CrackpotGumption/mole_code/instructable/project/drawings/06_controller_schematic.png

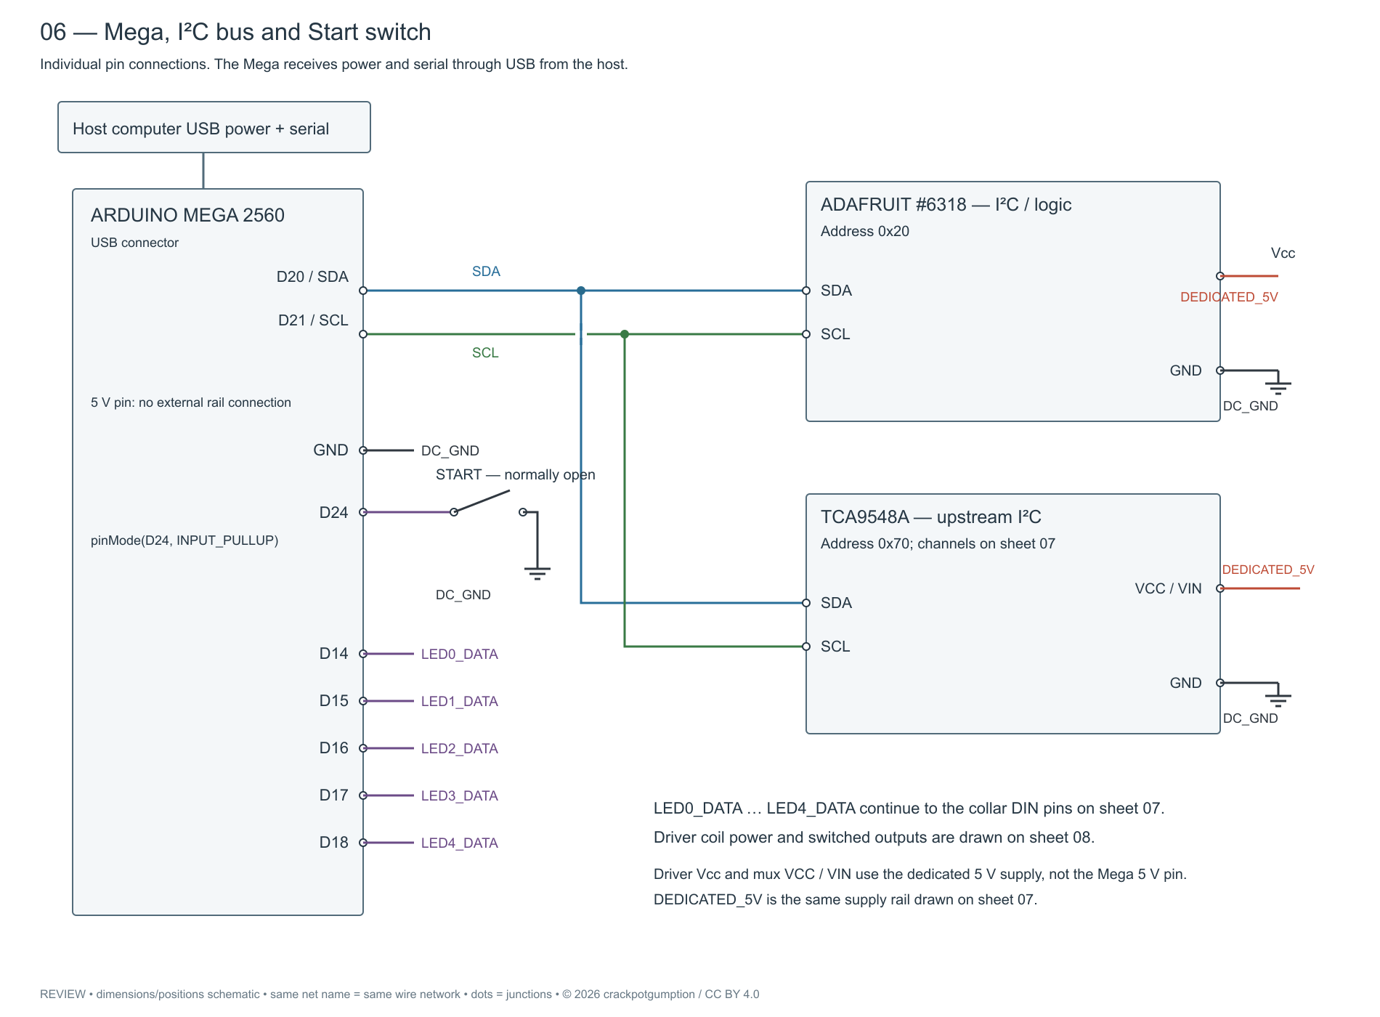
instructable/project/drawings/06_controller_schematic.png
