CrackpotGumption/mole_code/portal/audio-preview.jpg

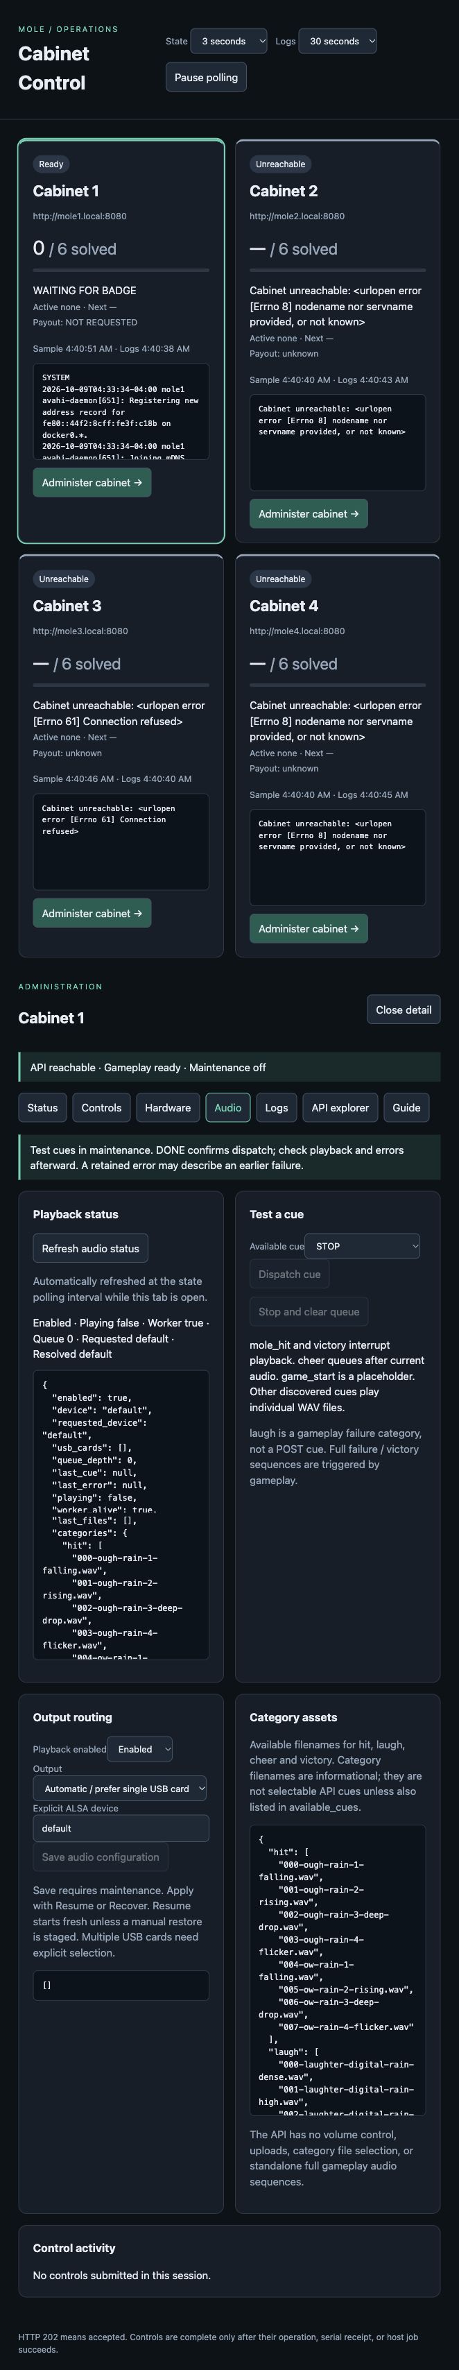
portal/audio-preview.jpg
