CrackpotGumption/mole_code/portal/preview.jpg

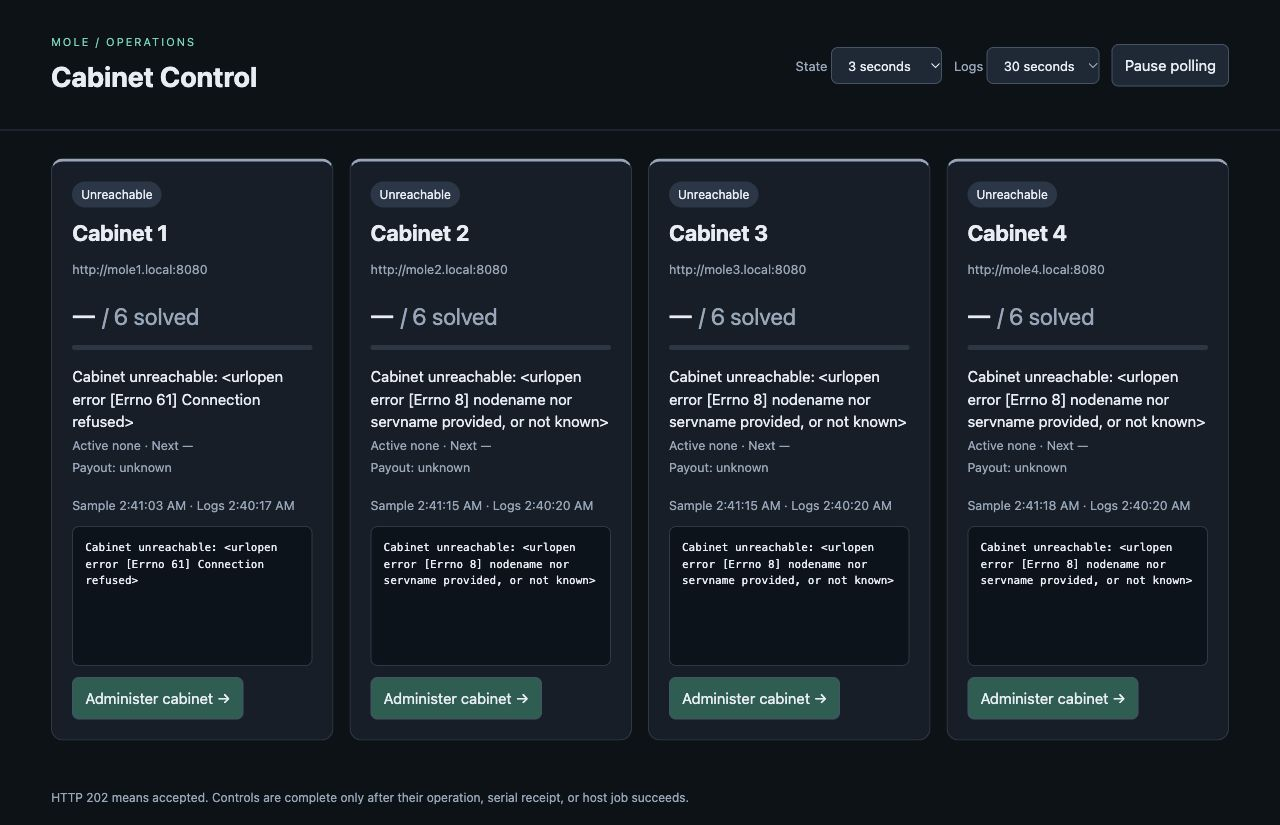
portal/preview.jpg
