CrackpotGumption/mole_code/instructable/project/BOM.md

# Supplies — one cabinet

*Amazon links are affiliate links. As an Amazon Associate I earn from qualifying purchases.*

Quantities below describe one cabinet. Pack sizes and spool/tube lengths describe the linked purchase, not the amount required. Prices are omitted.

## Cabinet

- [Scotch black Extreme Fasteners RF6741, 1-inch × 4-foot, two rolls](https://www.homedepot.com/p/Scotch-1-in-x-4-ft-Black-Extreme-Fasteners-2-Rolls-RF6741/205520125), as needed for removable fastening. This was the removable fastener used in the build. Refer to it as interlocking removable fasteners rather than assuming a textile hook-and-loop construction.

- [Grip-Rite #8 × 2-inch construction screws, 2GCS1](https://www.homedepot.com/p/Grip-Rite-8-x-2-in-Star-Drive-Dual-Flat-Head-Coarse-Thread-Construction-Screws-1-lb-Box-2GCS1/204959257): 2×2-to-plywood connections; also caster fasteners where they enter the inner 2×2 rail.
- Four [3-inch rubber swivel casters with brakes, Harbor Freight item 61855](https://www.harborfreight.com/3-in-rubber-light-duty-swivel-caster-with-brake-61855.html). Mount about 1 inch in from the corners, catching the inner 2×2 framing on at least one side. Use 2-inch screws into the rail and ¾-inch screws on the other side.
- Screw-use clarification: 2½-inch screws were used for 2×2-to-2×2 connections; 2-inch screws for 2×2-to-plywood connections. Do not use the 2½-inch frame screws for the plywood connection pattern.

Confirmed ¾-inch plywood cuts: three 36 × 24-inch panels (two sides and top/playfield), one 36 × 23.25-inch bottom, one 36 × 35.25-inch front, and two 19.2 × 35.75-inch deck panels. The bottom's ¾-inch front setback allows the front panel to drop down and align with the sides. See PLYWOOD_CUT_LIST.md; sheet nesting and hole details remain to be drawn.

- Five [Oatey Fast Set flanges, model 435032, 3-inch outside fit / 4-inch inside fit](https://www.homedepot.com/p/Oatey-Fast-Set-3-in-Outside-Fit-or-4-in-Inside-Fit-PVC-Open-Hub-Toilet-Flange-435032/100344482).
- [Charlotte Pipe 3-inch Schedule 40 PVC, 2-foot purchase length](https://www.homedepot.com/p/Charlotte-Pipe-3-in-x-2-ft-PVC-DWV-Sch-40-Pipe-PVC073000200HA/100533056). Cut five 2-inch sleeves. About one foot including cutting waste is sufficient; buy a shorter length or request store cuts if available.
- [Everbilt #8 × 1-inch flat-head wood screws, 100-pack](https://www.homedepot.com/p/Everbilt-8-x-1-in-Zinc-Plated-Phillips-Flat-Head-Wood-Screw-100-Pack-801822/204275495): mechanism and flange fastening; at least 40 for puck/base mounts plus flange screws and spares.
- [Everbilt #8 × ¾-inch flat-head wood screws, 100-pack](https://www.homedepot.com/p/Everbilt-8-x-3-4-in-Phillips-Flat-Head-Zinc-Plated-Wood-Screw-100-Pack-801812/204275494): shorter mounting fasteners; final placement/count to be documented.
- [Grip-Rite #8 × 2½-inch general-purpose wood screws](https://www.homedepot.com/p/Grip-Rite-8-x-2-1-2-in-2-Phillips-Bugle-Head-Coarse-Thread-Wood-Screws-1-lb-Box-212GS1/100128995): frame joints.
- [Kreg K4 pocket-hole jig](https://www.amazon.com/dp/B001DYFISG?tag=crackpotgum00-20): one tool.
- [LIONMAX #8 × 2½-inch pocket-hole screws](https://www.amazon.com/dp/B0C23LJ6LJ?tag=crackpotgum00-20): pocket-hole joints in the nominal 2×2 framing; linked pack contains 300 screws, not the required cabinet quantity.
- Pneumatic thread tape is supplied with the tubing/solenoid purchases. No separate tape purchase is needed for the documented build; use only on compatible threaded joints.

| Supply | Quantity | Use / remaining check |
|---|---|---|
| [ZANEXIR black felt sheet, 36 × 36 inches, 1 mm](https://www.amazon.com/dp/B0GV7ZK5MX?tag=crackpotgum00-20) | 1 sheet | Trim for the 36 × 34.5-inch rear cover. Confirm stiffness/suitability; listing is 1 mm, not heavy felt. |

## Pneumatics

| Supply | Quantity | Use / remaining check |
|---|---|---|
| [TAILONZ MAL16×75 double-acting cylinder, 16 mm bore × 75 mm stroke](https://www.amazon.com/dp/B08CZ39Y42?tag=crackpotgum00-20) | 5 | Includes fittings listed as 6 mm. The builder confirms these work with the linked ¼-inch tubing in the completed build. Rod/base thread sizes remain to be recorded. |
| [AIRIX 4V210-08 12 V five-way, two-position valve, ¼-inch NPT](https://www.amazon.com/dp/B0F2MQF6K7?tag=crackpotgum00-20) | 5 | Listing states 25–116 PSI and pilot operation. Confirm operation at the approximately 25 PSI setting under load; verify physical port markings. |
| [TAILONZ blue polyurethane air tubing, ¼-inch OD, 200 ft](https://www.amazon.com/dp/B09CPG48SL?tag=crackpotgum00-20) | As needed | Compressor/manifold/valve/cylinder runs; 200 ft is purchase length, not a one-cabinet requirement. |
| [TAILONZ straight push fittings, ¼-inch tube OD × ¼-inch MNPT, 20-pack](https://www.amazon.com/dp/B08F4YHR1V?tag=crackpotgum00-20) | Count after routing | For compatible ¼-inch NPT ports; not assumed to fit cylinder ports. |

## Power and electronics

| Supply | Quantity | Use / remaining check |
|---|---|---|
| [Amazon Basics six-outlet surge-protected power strip, 2-pack](https://www.amazon.com/dp/B0D1XNYKD5?tag=crackpotgum00-20) | 1 strip | Electronics only. Compressor has a separate external cord/outlet. |
| [12 V 5 A power adapter](https://www.amazon.com/dp/B07GFFG1BQ?tag=crackpotgum00-20) | 1 | Valve-coil supply; separate from 5 V supply. |
| [AITRIP TCA9548A eight-channel I²C multiplexer, 6-pack](https://www.amazon.com/dp/B08JGSMRF9?tag=crackpotgum00-20) | 1 board | Five sensors use channels 0–4; purchase pack contains spares. |
| [Mega 2560 screw-terminal breakout board](https://www.amazon.com/dp/B0BY8SHQZS?tag=crackpotgum00-20) | 1 | Controller wiring termination. Check fit against the actual Mega; listing has inconsistent board-compatibility text. |
| [ELEGOO Mega 2560 R3 board](https://www.amazon.com/dp/B01H4ZDYCE?tag=crackpotgum00-20) | 1 | Hardware controller, USB-powered by host. |

## Wiring

- [18 AWG feeder wire](https://www.amazon.com/dp/B07FMWNF3J?tag=crackpotgum00-20), as needed for the deck power feeders.
- The linked Fermerry 22 AWG wire is the builder's general-use wiring; keep the 18 AWG power feeders separate.

- [WAGO 221-412 two-conductor lever connectors](https://www.amazon.com/dp/B00JB3U7Y6?tag=crackpotgum00-20), as needed for harness connections.
- [Zip-tie mounts](https://www.amazon.com/dp/B09B8NY4SN?tag=crackpotgum00-20), as needed for cable routing and moving-wire management.

| Supply | Quantity | Use / remaining check |
|---|---|---|
| [Mini PCB screw-terminal connector assortment, 2.54 mm pitch](https://www.amazon.com/dp/B0FCXV6GT3?tag=crackpotgum00-20) | As needed | Sensor and low-voltage wiring connections; not the main power-distribution blocks. |
| [Amazon Basics multicolor electrical tape, 10-pack](https://www.amazon.com/dp/B07YDSNGCT?tag=crackpotgum00-20) | As needed | Wire labeling and insulation. |
| [Fermerry 22 AWG silicone stranded wire, six colors, 100 ft each](https://www.amazon.com/dp/B089D3LVYK?tag=crackpotgum00-20) | As needed | Low-current signal/sensor wiring and suitably sized pigtails; retain larger deck feeders sized for load. |

## Printed parts

| Supply | Quantity | Use / remaining check |
|---|---|---|
| [ELEGOO black PLA Plus, four 1 kg spools](https://www.amazon.com/dp/B0C7GDB9GQ?tag=crackpotgum00-20) | As needed | Black structural parts. Generic PLA is the saved slicer profile; material amount is not yet estimated. |
| [ELEGOO white PLA, four 1 kg spools](https://www.amazon.com/dp/B0BV24RX9Q?tag=crackpotgum00-20) | As needed | White diffuser rings; select white filament rather than the saved black project color. |

## Finish

| Supply | Quantity | Use / remaining check |
|---|---|---|
| [TECKWRAP silver chrome adhesive vinyl, 1 ft × 5 ft](https://www.amazon.com/dp/B07CZCZ4MB?tag=crackpotgum00-20) | As needed | Cabinet graphics and accents. |
| [Flutesan silver ¾-inch T-molding, 25 ft](https://www.amazon.com/dp/B0H8YJY3ZR?tag=crackpotgum00-20) | As needed | Cabinet edge trim; match slot cutter to trim and test on scrap. |
| [Rust-Oleum Bright Coat chrome spray paint, 11 oz](https://www.amazon.com/dp/B000Z8DGXK?tag=crackpotgum00-20) | As needed | Chrome finish on printed collars and accents. |

## Tools and adhesives

| Supply | Quantity | Use / remaining check |
|---|---|---|
| [Surebonder CL-800F full-size cordless hot glue gun](https://www.amazon.com/dp/B001AH5EXK?tag=crackpotgum00-20) | 1 tool | Collar retention and mounting; keep serviceable parts removable. |
| [Gorilla heavy-duty double-sided mounting tape, 1 × 120 inches](https://www.amazon.com/dp/B082TQ3KB5?tag=crackpotgum00-20) | As needed | Mounting panels and speakers; consider later removal. |
| [Self-adjusting ferrule crimper with ferrule assortment](https://www.amazon.com/dp/B0DRJ9CDNG?tag=crackpotgum00-20) | 1 tool kit | Terminate stranded wires in compatible screw terminals; match ferrule to wire size. |
| [Oatey PVC cement and purple primer handy pack](https://www.amazon.com/dp/B0002YU23O?tag=crackpotgum00-20) | 1 kit | Solvent-weld compatible PVC sleeves and closet flanges. |

## Other required supplies already specified

Pneumatic routing: each valve's default, de-energized state sends air to the top of its associated cylinder. Builder reports no additional pneumatic hardware beyond the linked fittings and cylinder-supplied fittings.

- ¾-inch plywood and nominal 2×2 lumber: use the cabinet/deck cut lists in the build steps.
- Five compatible closet flanges, five 2-inch sections of nominal 3-inch Schedule 40 PVC, casters, hook-and-loop fastening and wood screws.
- Ten [Pneuforce BESL-01 exhaust muffler/flow controls](https://pneuforce.com/pneumatic-exhaust-muffler-besl-01), two per valve. Builder identifies these as the installed parts.
- One [FORTRESS 2-gallon, 135 PSI ultra-quiet oil-free compressor, Harbor Freight item 64596](https://www.harborfreight.com/2-gallon-135-psi-ultra-quiet-oil-free-hand-carry-jobsite-air-compressor-64596.html). Use its regulated outlet; tank maximum pressure is not the cabinet operating pressure.
- One [six-connection manifold](https://www.amazon.com/dp/B0FCYNYHQF?tag=crackpotgum00-20).
- Five [MPU6050 breakout boards](https://www.amazon.com/dp/B0F9DLNHTB?tag=crackpotgum00-20); verify breakout voltage/pullups.
- One [Adafruit #6318 solenoid driver](https://www.adafruit.com/product/6318).
- 95 installed pixels (19 per collar), plus optional spares from [NeoPixel strip #1460](https://www.adafruit.com/product/1460); builder confirms 19 per collar.
- One [5 V 10 A supply](https://www.amazon.com/dp/B0D76F4W1C?tag=crackpotgum00-20), and five [power-distribution blocks](https://www.amazon.com/dp/B07CLW5FPS?tag=crackpotgum00-20) sized as described in the wiring step.
- One host computer, for example a [used small-form-factor workstation](https://www.ebay.com/itm/398398540633). The builder used similar computers with varying models; the listing is an example, not an exact required model. It needs USB power and data for the Arduino Mega, USB-speaker or other audio-output support, and the ability to run Python. A Raspberry Pi could also serve as the host. Size and computing power were not selection constraints.
- One pair of [Logitech S150 USB speakers](https://www.amazon.com/dp/B000ZH98LU?tag=crackpotgum00-20).
- [Amazon Basics USB-A to USB-B cable](https://www.amazon.com/dp/B00NH13DV2?tag=crackpotgum00-20), optional longer cable for bench testing. The cable included with the Mega can be used in the cabinet.
- Suggested [Twidec normally-open momentary Start button, 16 mm variant](https://www.amazon.com/dp/B08JHVLK84?tag=crackpotgum00-20), one used from the pack. Suggested for the standalone build, not an identified original button. Measure the received button before drilling. Connect between the Start input and ground using INPUT_PULLUP.
- Five each of printed body, retainer, guard, cylinder base, collar and diffuser; optional decoration adapters. Use the confirmed production 3MF and preserve its modifier and negative volumes.
- At least forty #8×1-inch countersunk screws for retainer/base mounts and ten captured nuts supplied with the linked cylinders; reuse them in the printed mounts rather than buying separate nuts.
- Black paint, satin water-based clearcoat, optional chrome marker, strain relief, cable mounts and appropriate circuit protection.

## Link format verification

Clean format: `https://www.amazon.com/dp/ASIN?tag=crackpotgum00-20`. Remove order-history `ref=` and `th=1` navigation parameters; preserve each supplied ASIN. If a URL already has a necessary query parameter, append `&tag=crackpotgum00-20` instead of a second `?`.

[Amazon’s text-link documentation](https://affiliate-program.amazon.com/help/node/topic/GP38PJ6EUR6PFBEC) uses the `tag` query parameter for the Associate ID. [Amazon’s tagging check](https://affiliate-program.amazon.com/help/node/topic/G6253GFSARDQENZR) describes checking manually constructed links. The URL syntax is verified; account ownership/commission credit was not checked.
