CrackpotGumption/mole_code/instructable/project/UNLINKED_PARTS.md

# Parts and supplies without product links

Reviewed October 14, 2026 against the live draft, BOM, assembly steps and original hardware notes. These are missing product links in the current draft, not automatically missing purchases. Non-Amazon destinations need no Amazon affiliate tag. Generic materials can be specified without a particular brand.

## Cabinet and mechanism hardware

- 3/4-inch plywood and nominal 2x2 lumber; final sheet/board quantities need the checked cut layout.
- Resolved: four Harbor Freight 61855 3-inch rubber swivel casters with brakes, linked in BOM. Mounting uses linked 2-inch and ¾-inch screws.
- Link supplied: Scotch Extreme Fasteners RF6741 for removable connections. This was the product used; the purchase-link request is resolved.
- Resolved: Oatey Fast Set 435032 flanges, Charlotte Pipe 3-inch Schedule 40 PVC, and #8 × 1-inch Everbilt flat-head screws now have Home Depot links in the BOM.
- Resolved: all ten captured nuts are supplied with the linked cylinders and reused in the wood/printed mounts; no separate product link is needed.
- Resolved links: #8 × ¾-inch Everbilt screws, #8 × 2½-inch Grip-Rite frame screws, Kreg K4 jig, #8 × 2½-inch LIONMAX pocket screws and Grip-Rite #8 × 2-inch 2GCS1 panel screws. Frame-to-frame uses 2½-inch screws; frame-to-plywood uses 2-inch screws. Final quantities remain to be recorded.
- Five soft target decorations; optional theme parts, actual sources needed only if included in the guide.

## Pneumatics

- Resolved: compressor is FORTRESS Harbor Freight item 64596; supplier link added to BOM.
- Resolved: ten exhaust controls are Pneuforce BESL-01; supplier link added to BOM.
- Builder reports no additional pneumatic hardware. The straight push-to-connect fittings and supplied cylinder fittings are already covered; no additional adapters are requested.
- Resolved: thread tape came with the tubing/solenoid purchases; no separate link/purchase needed.
- Leak-test soap/solution; generic consumable.
- Any separate air-isolation/vent hardware added to the final build; identify only if installed or specified, not as an assumed existing part.

## Electronics and wiring

- Resolved: host computer has an example eBay link, https://www.ebay.com/itm/398398540633. Model is flexible: USB power/data for the Mega, speaker output and Python support. A Raspberry Pi is an alternative.
- Resolved: Logitech S150 USB speakers and optional longer Amazon Basics USB-A to USB-B bench cable are linked. The cable included with the Mega can be used instead.
- Resolved: suggested Twidec normally-open momentary Start button, https://www.amazon.com/dp/B08JHVLK84?tag=crackpotgum00-20. The listed variant is 16 mm; verify the received switch before drilling. This is a suggested component, not an identified original button.
- Resolved: 18 AWG feeder wire B07FMWNF3J and general-use 22 AWG Fermerry wire B089D3LVYK are linked. No repeat request for these wire sources is needed.
- Resolved: WAGO 221-412 two-conductor lever connectors and zip-tie mounts are linked in BOM. Any separately used terminal rails, cable ties, clamps/strain relief and equipment-mounting hardware remain generic or unlinked.
- Solder and any heat-shrink insulation used in the harness.
- Mains enclosures, branch fuses/fuse holders or other circuit protection included in the final design; exact implementation remains to be specified.
- Separate compressor power cord/extension cable, if one is purchased separately rather than integral to the compressor.
- NeoPixel data resistors and supply capacitor(s) if the recommended additions are adopted; these are not documented as original installed parts.

## Finish and adhesives

Owner does not require exact finish-product links. Keep paint, clearcoat, marker, adhesives, filler, sandpaper and painting supplies generic; the following historical references are optional and are not outstanding owner requests.

- Glidden Spred Grab-N-Go black semi-gloss paint/primer.
- Minwax Polycrylic Satin water-based clearcoat. Original notes include a Lowe's product URL; it has not been carried into the draft: https://www.lowes.com/pd/Minwax-Polycrylic-32-fl-oz-Satin-Water-based-Polyurethane/999913687
- Optional Faber-Castell chrome acrylic marker. Original notes include a Michaels URL; it has not been carried into the draft: https://www.michaels.com/product/fabercastell-chrome-acrylic-paint-marker-10812167
- Superglue for the documented sensor/adapter mounting method.
- Hot-glue sticks; the glue gun is already linked.
- Seam/wood filler, sandpaper and painting supplies; generic finishing consumables, exact products not recorded.

## Optional items and tools

- Optional Deltronic Labs DL-1275 ticket dispenser, compatible tickets and mounting fasteners; optional printed bin/saddle are already in the production 3MF. Keep these separate from the standalone game requirements.
- Router and slotting cutter matched to the T-molding barb.
- Saw/jigsaw, pocket-hole jig, drill/driver, compact/right-angle driver, soldering equipment, multimeter and measuring tools; list as tools rather than cabinet parts. Exact brands are not necessary.
- 3D printer; the saved profile uses a Bambu P1S/0.4 mm nozzle. A purchase link is optional.

## Already covered

All 22 owner-supplied Amazon ASINs plus manifold, MPU6050 boards, 5 V supply and power-distribution blocks are linked. The solenoid driver and NeoPixel strip are linked to Adafruit. The production 3MF covers the printed parts, and the seven Step 7 downloads cover the standalone software and setup instructions. These do not need additional Amazon links.
