CrackpotGumption/mole_code/instructable/mole_assembly_final.3mf

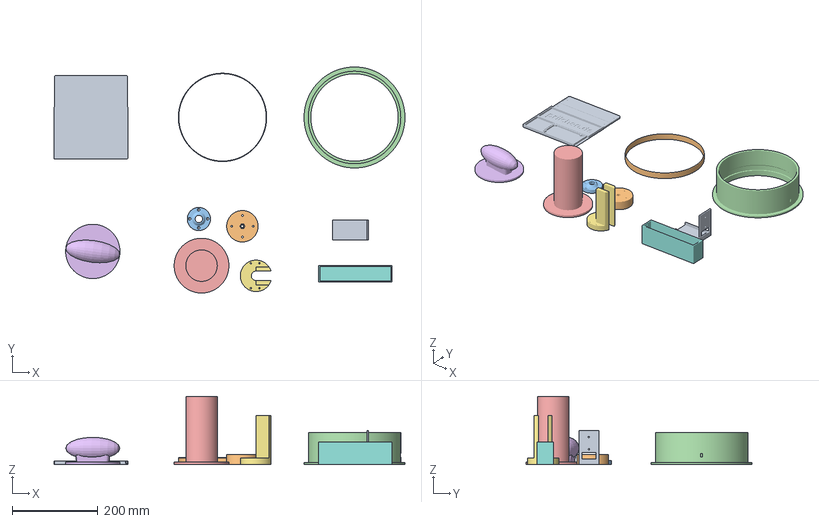
[picture p4: CAD file, 2026-10-13]
instructable/mole_assembly_final.3mf
816.9 x 526.0 x 158.8 mm
mega_breadboard_holder_2x_terminal(1).stl
mole_collar_diffuser_ring(5).stl
MAL16_mounting_plate_test(4).stl 5 2
mole_collar_70mm_led(8).stl
mole_bottom_rebuilt_true_cylinders_73p2mm.stl 3
mole_2_A_clean_cylindrical_base.stl
pneumatic_mount_4_COUNTERSUNK_UNDERSIDE_PUCK_ONLY_v21.stl
ticket_bin_165mm_internal.stl
ticket_saddle_7mm_sidewalls.stl
piston_mount_non_hex_countersinks.stl
