CrackpotGumption/mole_code/instructable/project/DRAFT_STATUS.md

# Seeded draft status — October 13, 2026

October 14 license update: owner selected MIT for standalone software and setup documentation, and CC BY 4.0 for the creator's print designs, article, diagrams and build photos. Attribution is crackpotgumption. Notices and downloadable LICENSES.txt were verified in the saved preview. Both local ZIP bundles include license notices. The project remains unpublished.

Editor: https://www.instructables.com/editor/EUCG6YTMUX7Z4OJ
Preview: https://www.instructables.com/preview/EUCG6YTMUX7Z4OJ/

Saved unpublished draft verified through its rendered preview. Eight reader-facing steps, introduction, organized supplies, numbered assembly instructions, checkpoints and troubleshooting. Ten original photographs are placed across the project; 5527.jpg is the cover. The production mole_assembly_final.3mf is attached and visible in preview. Main narrative contains no raw repository audit or owner TODO dump; those are maintained separately here.

Twenty-six Amazon product links use tag=crackpotgum00-20, including all 22 ASINs supplied by the owner; no Amazon link in the draft is missing the tag. The affiliate disclosure appears beside supplies. Manufacturer pinout and power guidance are linked in the electronics step.

Seven software attachments are attached to Step 7: STANDALONE.ino, PISTON_DIAGNOSTIC.ino, game.py, run.py, requirements.txt, test_game.py and standalone_setup.txt. The older README.txt attachment was removed from the step. ZIP uploads were rejected by the editor, so standalone_software.zip remains local.

Validation: six mocked Python tests passed; standalone sketch compiled for Mega (14,452 flash bytes, 801 RAM bytes); calibration sketch compiled for Mega (19,376 flash bytes, 1,586 RAM bytes). Physical hardware performance has not been verified. No new firmware was uploaded to a cabinet. Existing event-controller source remains unchanged by this task.

Remaining before publication: measured cut diagrams, breakout-specific wiring and pneumatic schematics, teardown photos, physical pixel/port/thread/button verification, print-profile review, and standalone cabinet calibration/testing. See OWNER_TODOS.md for the owner checklist and REPOSITORY_COMPARISON.md for discrepancies.
