CrackpotGumption/mole_code/instructable/project/ONLINE_EDITS_PENDING.md

# Online edits completed

Photo/testing placeholders added October 14: two photo slots in Step 3, pneumatic slot in Step 4, moving-wire slot in Step 5, and a ten-row unfilled testing table in Step 8. A duplicate pneumatic placeholder is also present in Step 5 and can be removed during final layout polish. Owner subsequently selected MIT plus CC BY 4.0; notices and LICENSES.txt are now saved in the draft.

October 14 latest additions saved and verified online: suggested Twidec Start button; 19 pixels per collar/95 total; WAGO 221-412 connectors; zip-tie mounts; 18 AWG feeders; 22 AWG general wiring; Grip-Rite 2-inch panel screws; four Harbor Freight 61855 casters and their mixed 2-inch/¾-inch fasteners. 2½-inch screws are for 2×2-to-2×2 joints. Updated 19-pixel STANDALONE.ino compiled successfully for Mega and replaced the older Step 7 attachment; the revised setup guide also replaced its older attachment. Exact finish products are not owner TODOs.

October 14 hardware/cuts update saved: five Home Depot links (flanges, PVC and three screw sizes), Kreg K4 jig and corrected LIONMAX pocket screws. Both Amazon additions use crackpotgum00-20. Thread tape is supplied with the pneumatic purchases. Seven plywood panel cuts are recorded in Step 2 and PLYWOOD_CUT_LIST.md. The supplies section still has an earlier provisional front/bottom note; the confirmed Step 2 cut list supersedes it and that note should be removed in the next edit.

October 14 follow-ups completed online: captured nuts are supplied with the linked cylinders; no separate purchase is needed. Added the used-workstation example with flexible requirements: runs Python, USB power/data for the Mega and speaker output. Docker was a use-case enhancement and is not a project requirement. Pneuforce exhaust controls and Harbor Freight compressor links are also present.

The user resumed browser work on October 13, 2026. The pending edits below were applied to the unpublished Instructables draft and checked in its rendered preview.

Completed:
1. The draft contains the permitted sentence: “The cabinet originally ran custom game logic for an event.”
2. Additional game descriptions and source/repository references were removed from the online draft.
3. The older README.txt attachment was removed from Step 7 and replaced with downloads/standalone_setup.txt.
4. The print step now reflects the confirmed production 3MF, which is attached to the project. Saved-profile facts are identified as saved settings that still require printer-specific verification.
5. The rendered preview was checked after saving. The project remains unpublished.
6. All 22 supplied ASINs and four existing Amazon links use tag=crackpotgum00-20. The affiliate disclosure is present.
7. The cylinder entry records the builder's confirmation that the included fittings work with the linked tubing.

Existing event source and internal audit notes are not publication assets.
