CrackpotGumption/mole_code/instructable/project/PLYWOOD_CUT_LIST.md

# Confirmed plywood cuts — one cabinet

All panels are ¾-inch plywood. Owner confirmed October 14, 2026.

| Part | Quantity | Width × other dimension |
|---|---:|---|
| Side panels | 2 | 36-inch height × 24-inch depth |
| Top/playfield | 1 | 36-inch width × 24-inch depth |
| Bottom | 1 | 36-inch width × 23.25-inch depth |
| Front | 1 | 36-inch width × 35.25-inch height |
| Pneumatic deck panels | 2 | 35.75-inch width × 19.2-inch depth |

The bottom is ¾ inch shorter at the front to let the front panel drop down and align with the side panels. Deck-panel dimensions replace the earlier approximate 36 × 19.2-inch panel dimensions; framing measurements are separate.

Hole locations and deck positioning were already supplied in BUILD_SPEC.md. Coordinates are inches from the front-left corner of the respective panel:

- Playfield centers: (6,6), (18,6), (30,6), (12,18), (24,18); five 8.5-inch cut openings.
- Deck centers: (6,3.75), (18,3.75), (30,3.75), (12,15.75), (24,15.75); approximately 4.25-inch flange openings, fitted to the specified flange.
- Deck is centered between the cabinet rails. Hole coordinates use each panel’s own front-left corner; differing depth coordinates account for the pneumatic deck origin relative to the cabinet origin. Support rails are about 15 inches below the upper rails.

Remaining agent drawing work: sheet nesting with saw kerf and annotated panel/hole/deck diagrams using these supplied dimensions. Do not ask the owner to provide these measurements again. These cuts do not establish an optimized sheet count.
