CrackpotGumption/mole_code/instructable/project/README.md

# Instructables project workspace

Draft editor: https://www.instructables.com/editor/EUCG6YTMUX7Z4OJ

ARTICLE.md is the reader-facing companion draft; the online draft contains eight formatted steps, introduction and supplies. WORKING_NOTES.md preserves the comprehensive handoff-derived notes. OWNER_TODOS.md lists missing owner assets and checks; REPOSITORY_COMPARISON.md records source evidence and discrepancies. software/ contains the standalone implementation used by the public guide.
