CrackpotGumption/mole_code/instructable/project/PUBLICATION_RULES.md

# Publication constraints

User instruction, October 13, 2026:
- mole_assembly_final.3mf is the cleaned final production set; all six plates/ten objects are production parts.
- The only permitted statement about original gameplay is: “The cabinet originally ran custom game logic for an event.”
- Never disclose further event-game details, rules, code, protocol descriptions specific to it, character/puzzle/player behavior, or repository links exposing its source.
- Public downloads may contain the production mechanical files and independent standalone software only.
- Internal handoff/comparison/working notes are not publication assets and must not be included in public bundles.
- Photos may contain original decoration/panel markings; do not explain or transcribe event gameplay visible in them.

Writing preference: direct factual prose. No flowery introduction or promotional language.
