CrackpotGumption/mole_code/instructable/mole_instructables_handoff/photos/5420.jpg

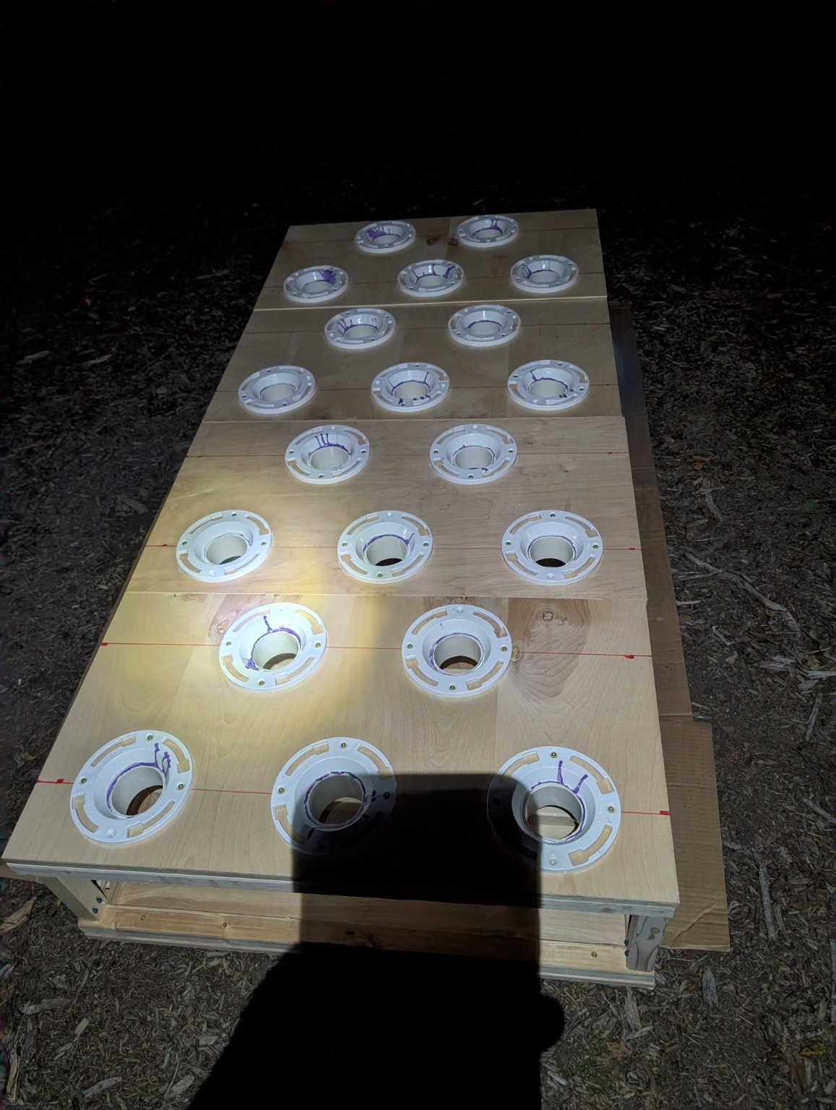
instructable/mole_instructables_handoff/photos/5420.jpg
