CrackpotGumption/mole_code/instructable/mole_instructables_handoff/photos/5501.jpg

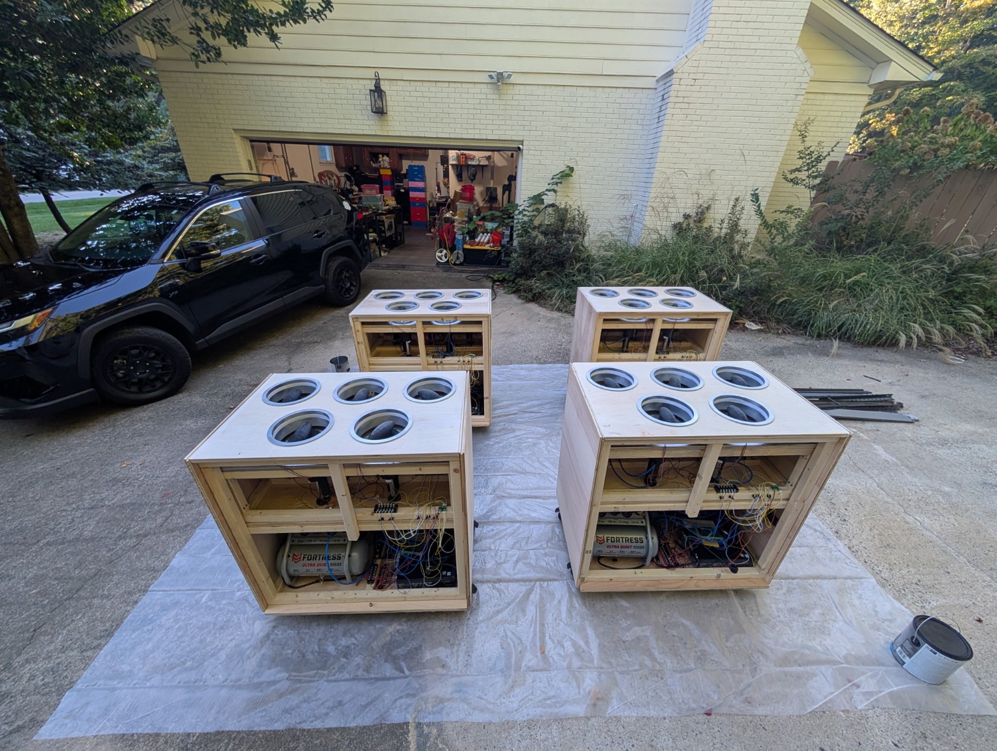
instructable/mole_instructables_handoff/photos/5501.jpg
