CrackpotGumption/mole_code/instructable/project/drawings/01_plywood_cuts.png

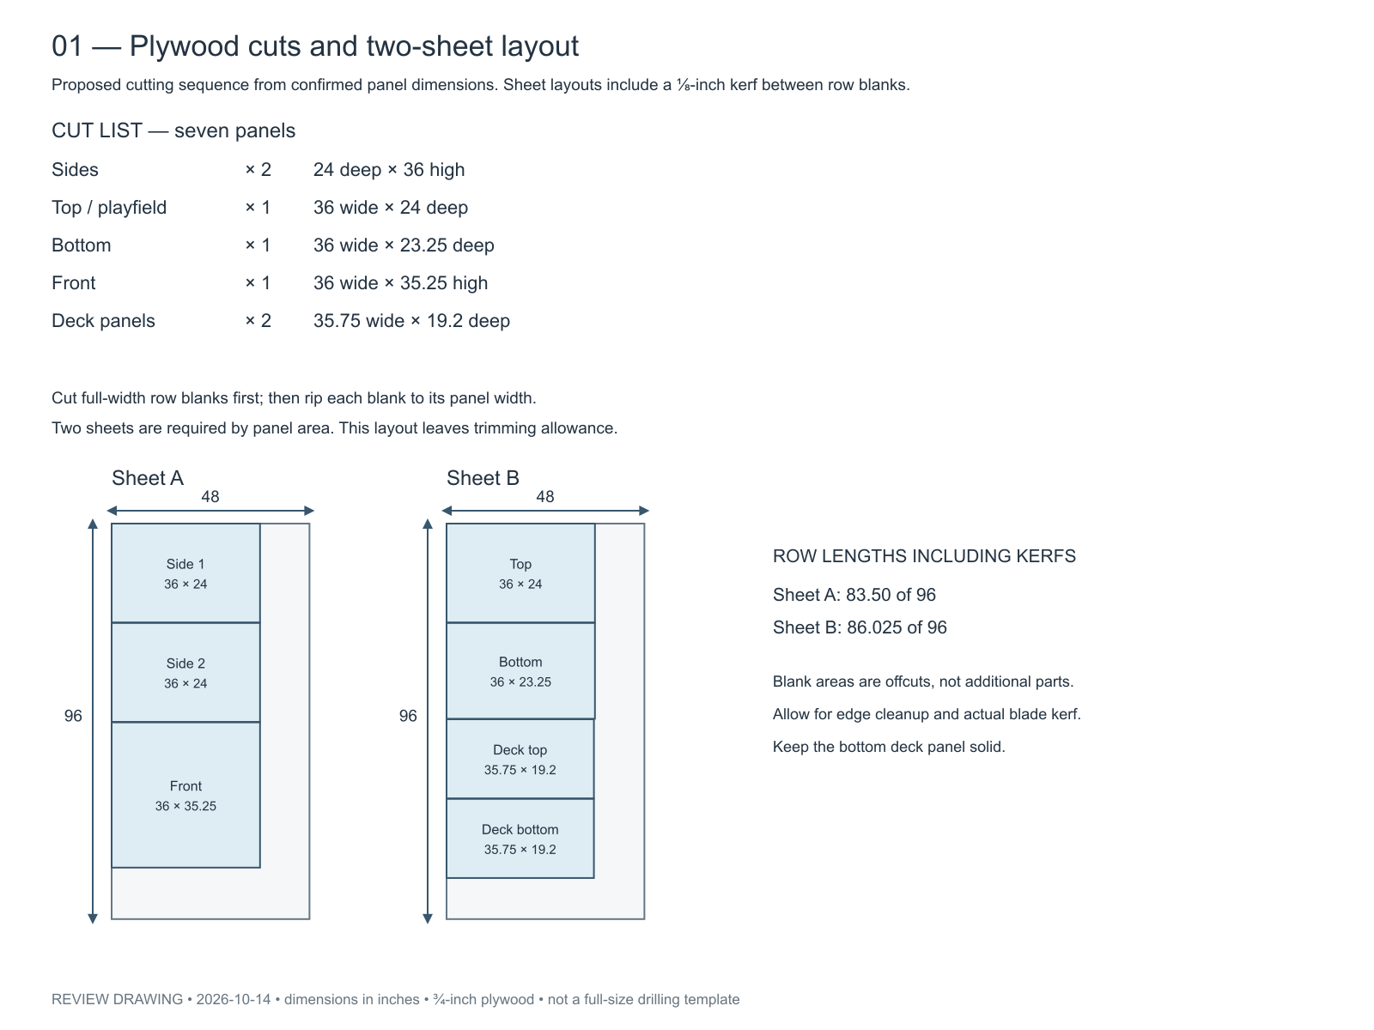
instructable/project/drawings/01_plywood_cuts.png
