CrackpotGumption/mole_code/instructable/project/drawings/02_hole_layouts.png

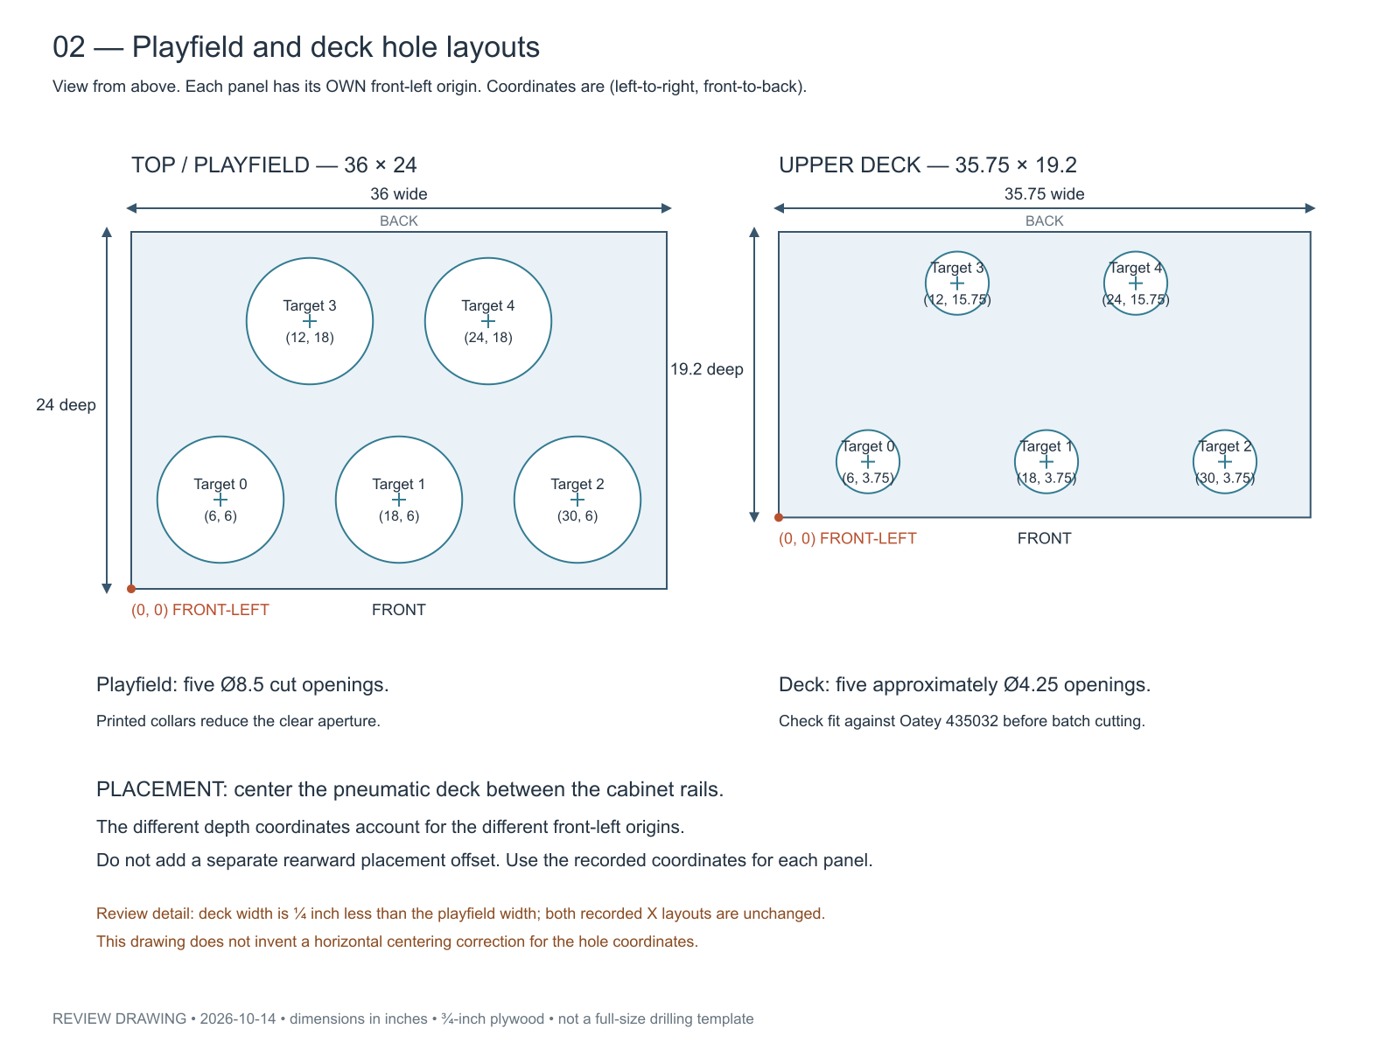
instructable/project/drawings/02_hole_layouts.png
