CrackpotGumption/mole_code/instructable/project/drawings/03_front_bottom_setback.png

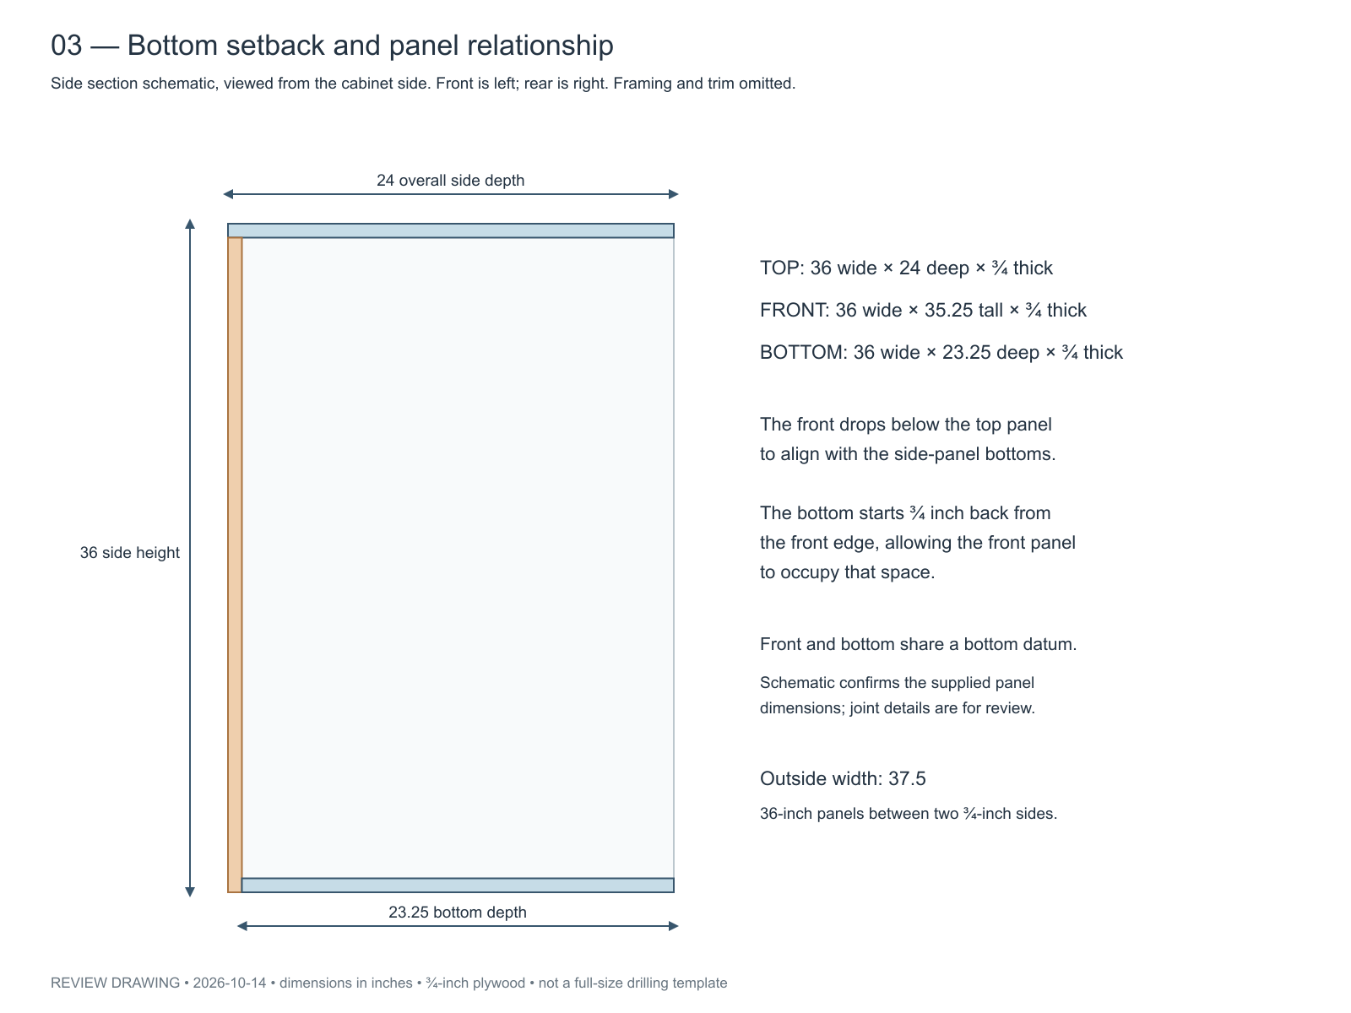
instructable/project/drawings/03_front_bottom_setback.png
