CrackpotGumption/mole_code/instructable/project/drawings/04_dc_power.png

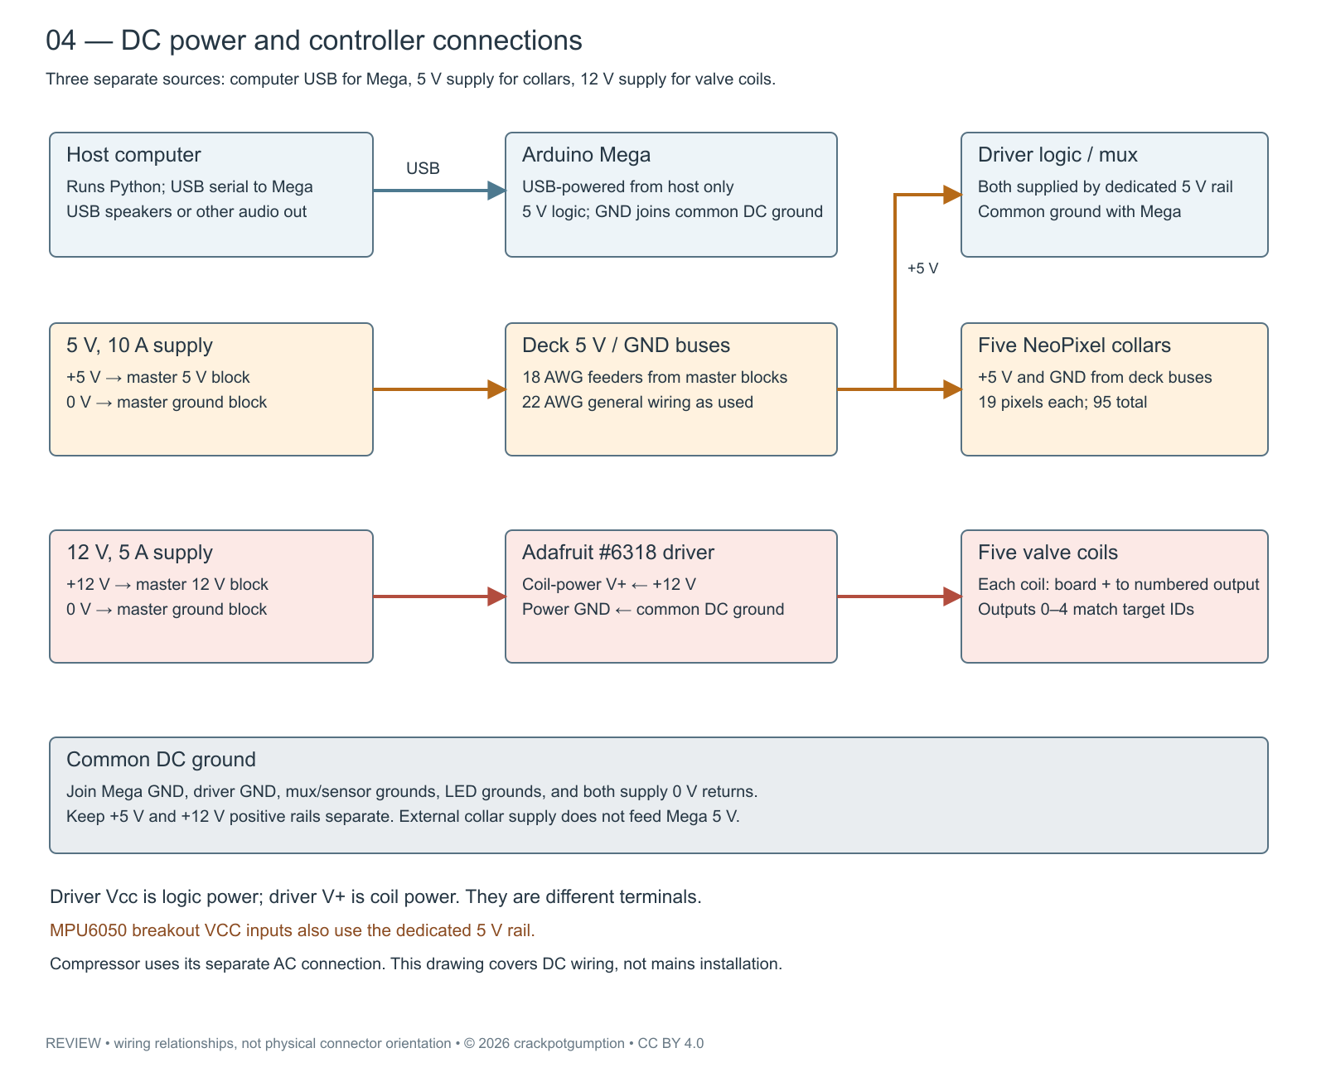
instructable/project/drawings/04_dc_power.png
