CrackpotGumption/mole_code/instructable/project/drawings/05_signal_mapping.png

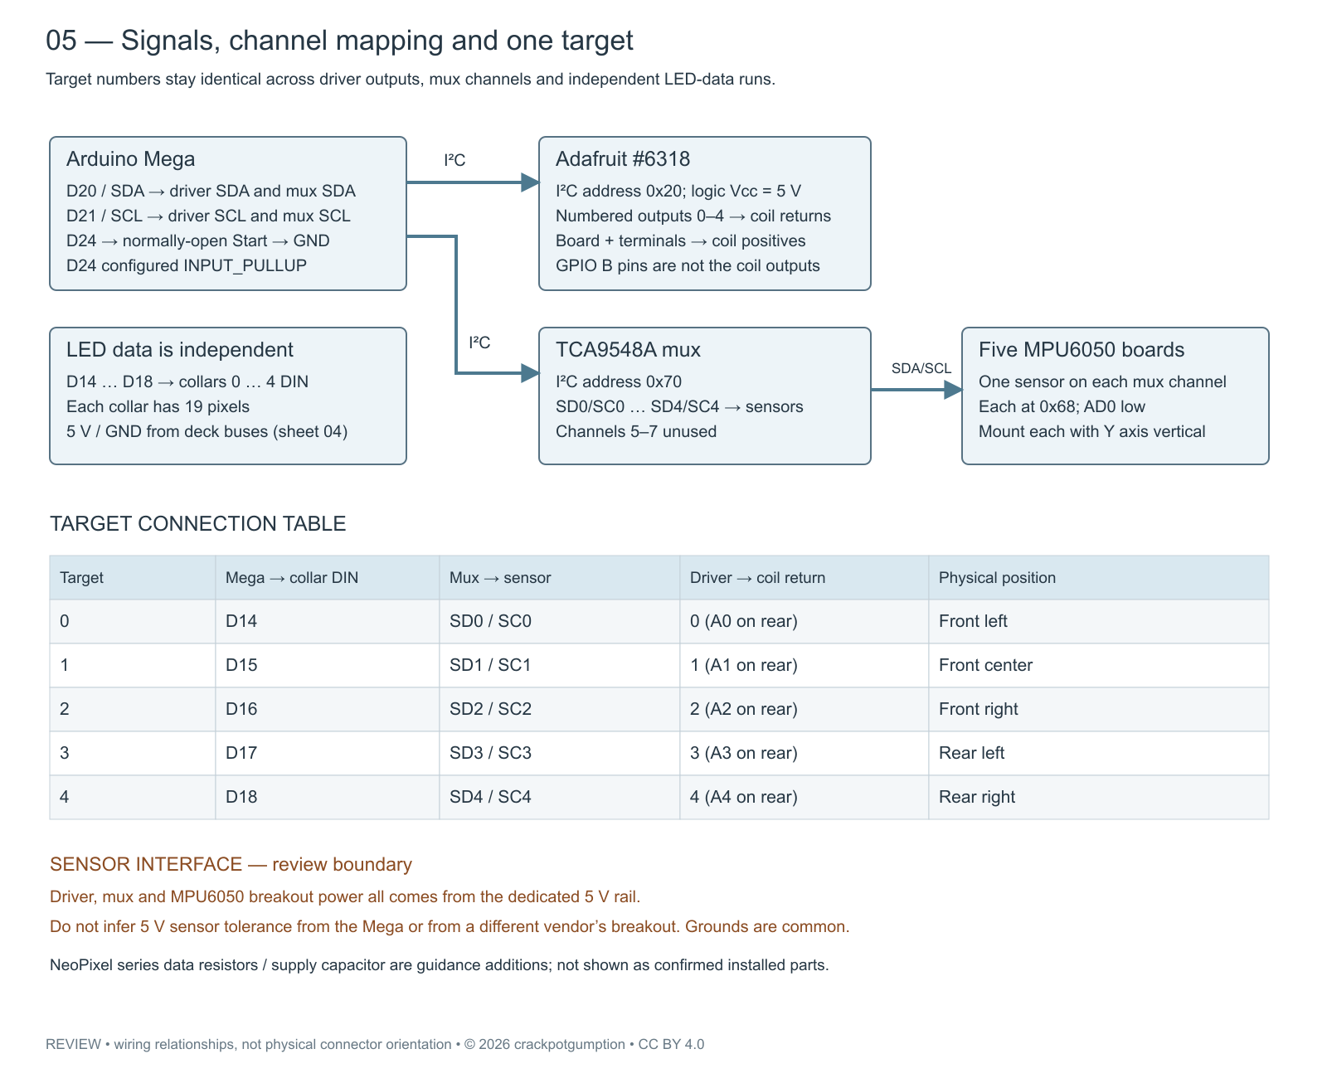
instructable/project/drawings/05_signal_mapping.png
