CrackpotGumption/mole_code/instructable/project/drawings/07_sensor_collar_wiring.png

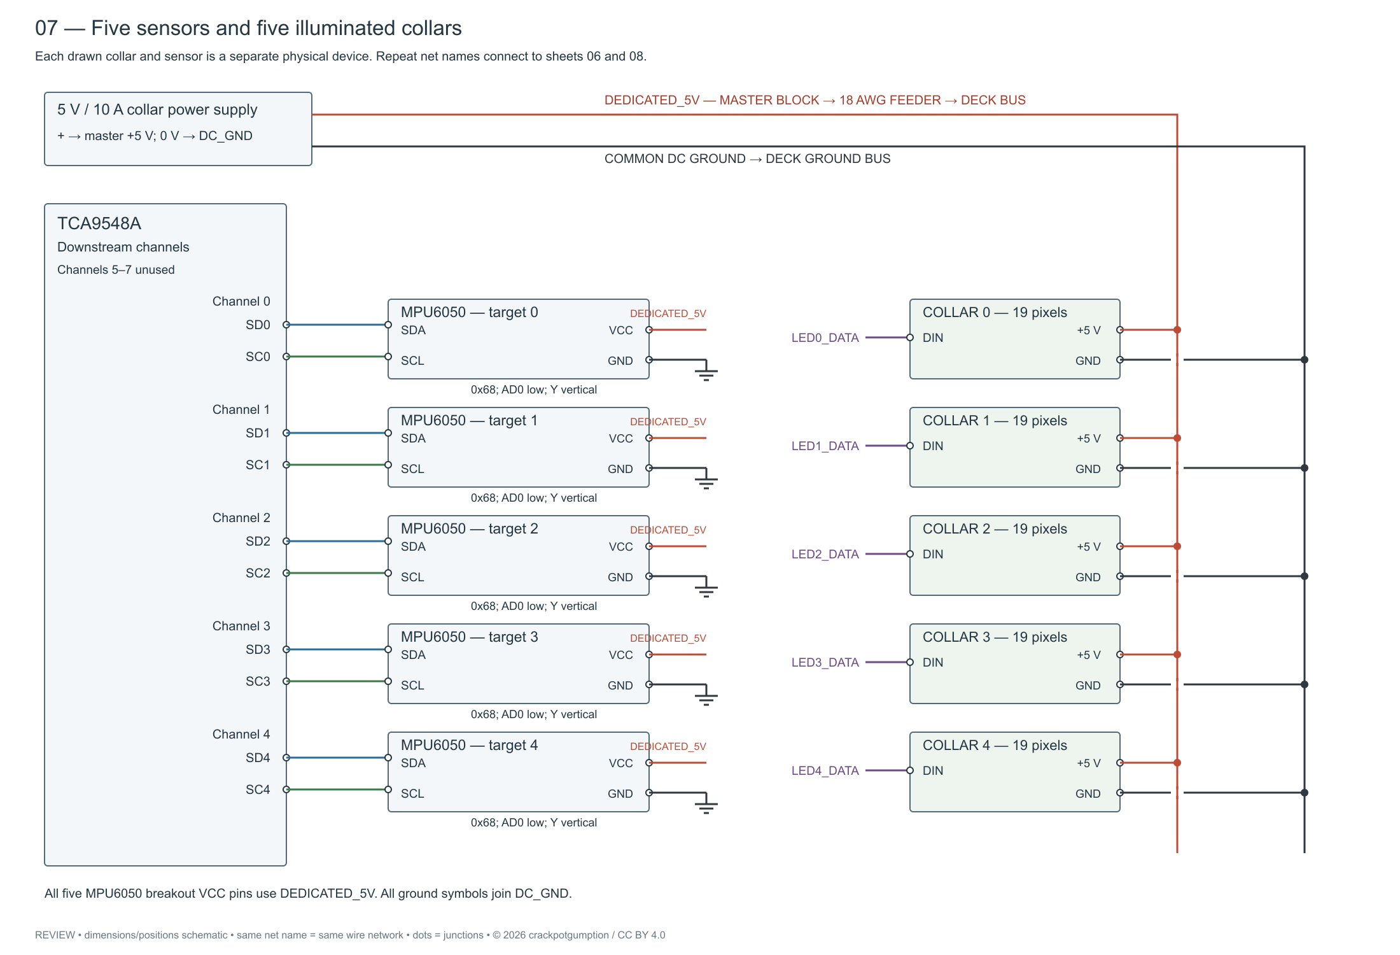
instructable/project/drawings/07_sensor_collar_wiring.png
