CrackpotGumption/mole_code/instructable/project/drawings/08_valve_coil_wiring.png

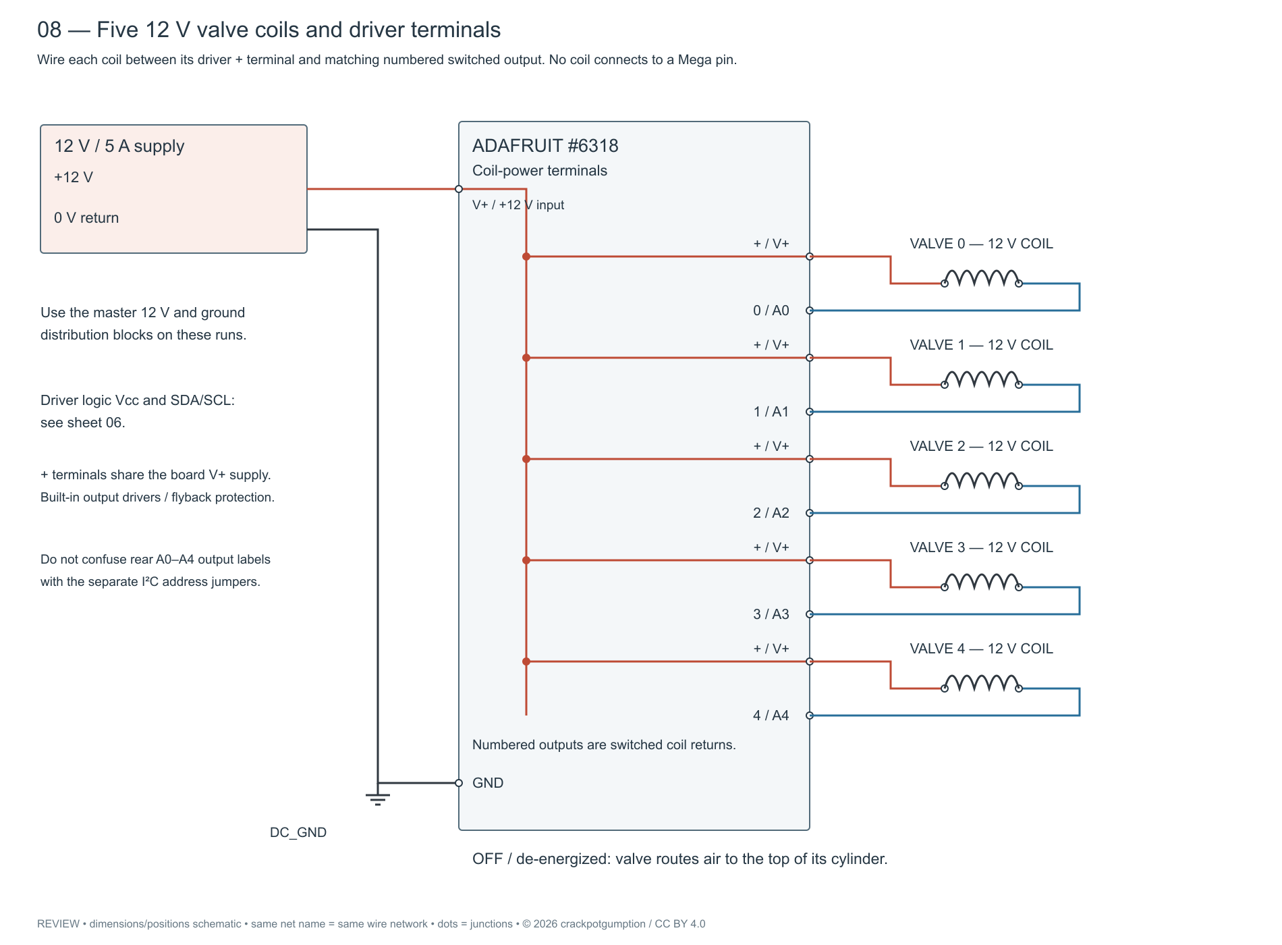
instructable/project/drawings/08_valve_coil_wiring.png
