CrackpotGumption/mole_code/instructable/project/drawings/09_pneumatic_channels.png

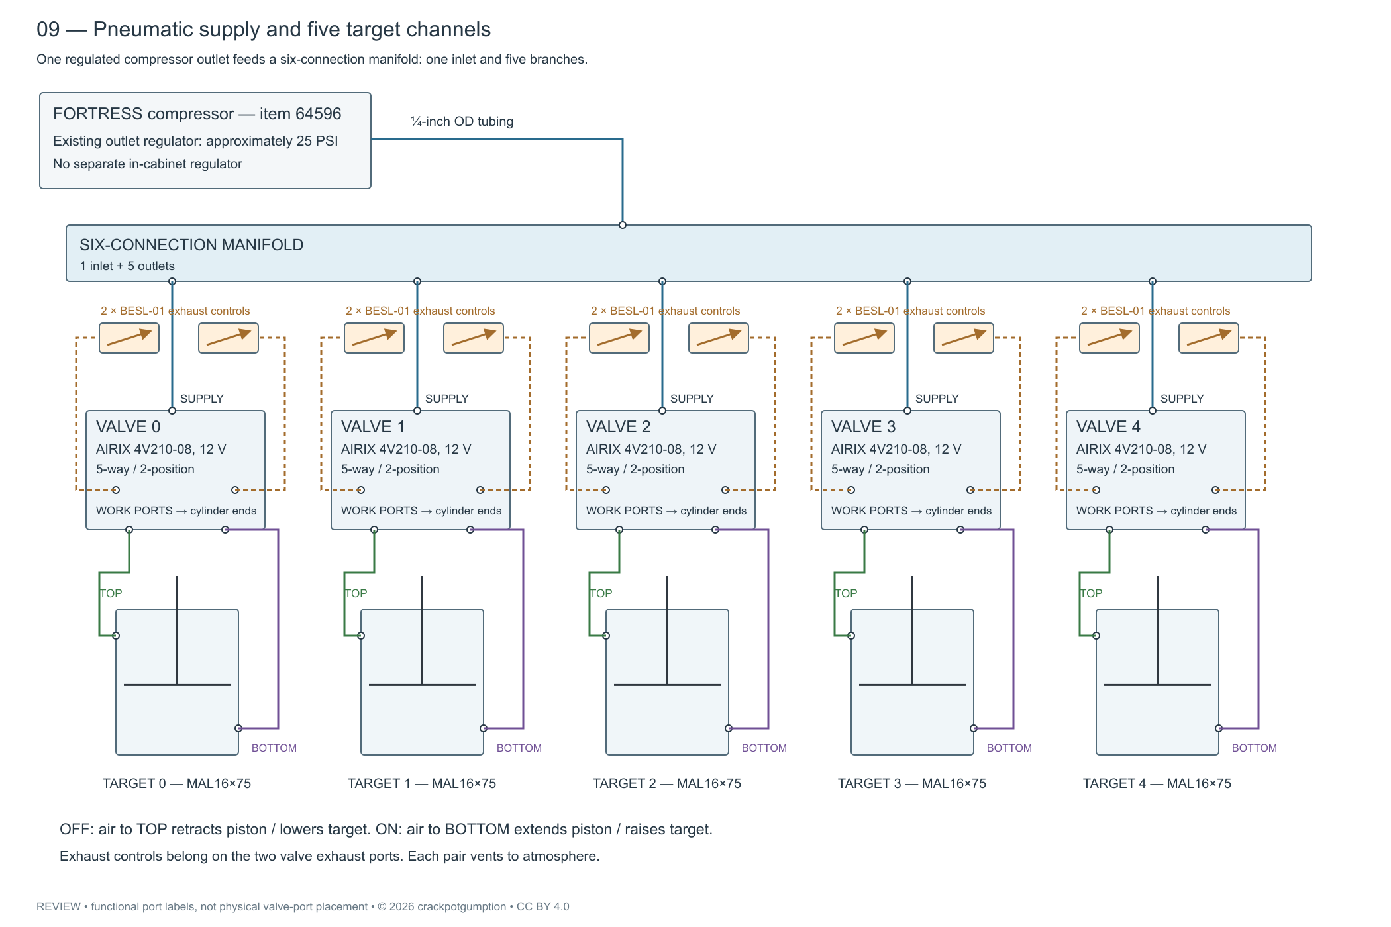
instructable/project/drawings/09_pneumatic_channels.png
