CrackpotGumption/mole_code/instructable/project/drawings/10_valve_states.png

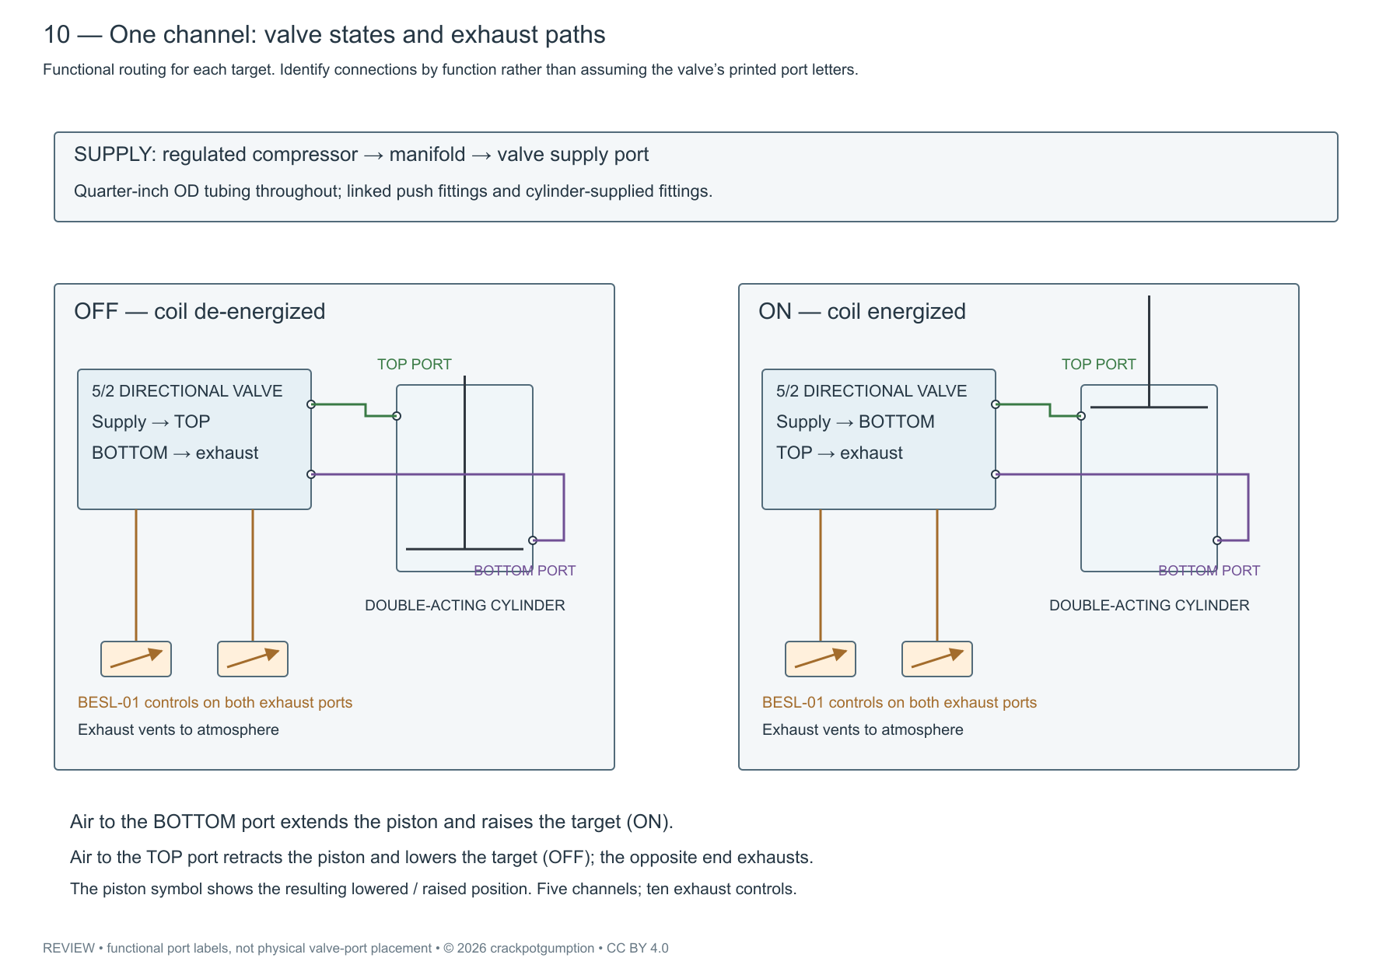
instructable/project/drawings/10_valve_states.png
