CrackpotGumption/mole_code/instructable/project/prints/previews/plate_1.png

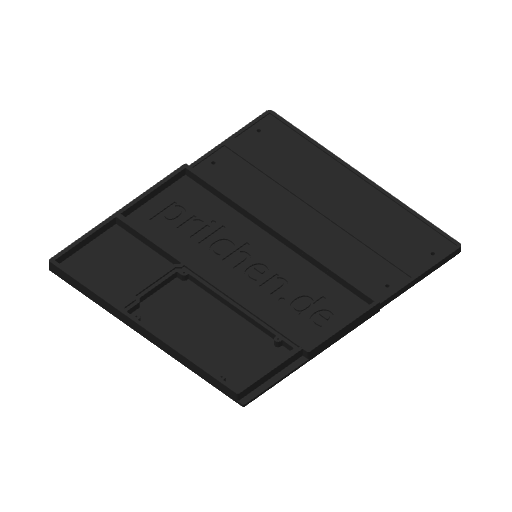
instructable/project/prints/previews/plate_1.png
