CrackpotGumption/mole_code/instructable/project/prints/previews/plate_2.png

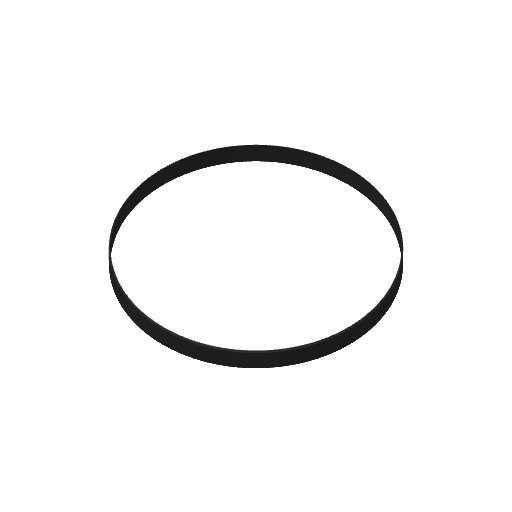
instructable/project/prints/previews/plate_2.png
