CrackpotGumption/mole_code/instructable/project/prints/previews/plate_3.png

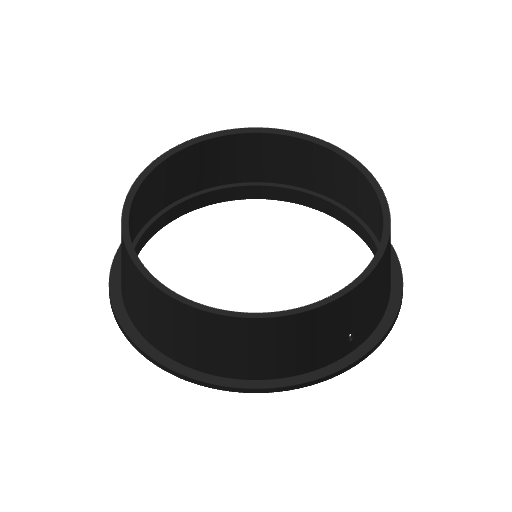
instructable/project/prints/previews/plate_3.png
