CrackpotGumption/mole_code/instructable/project/prints/previews/plate_4.png

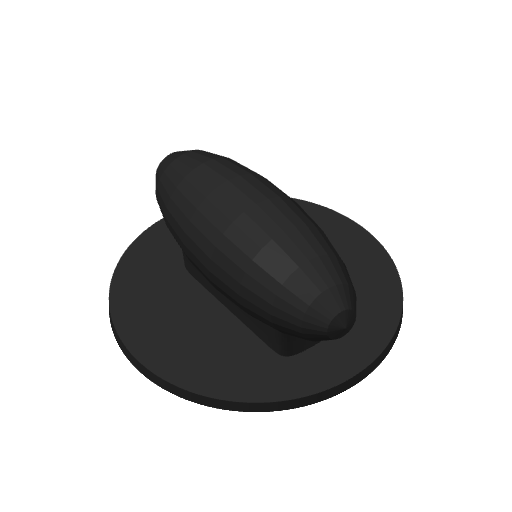
instructable/project/prints/previews/plate_4.png
