CrackpotGumption/mole_code/instructable/project/prints/previews/plate_5.png

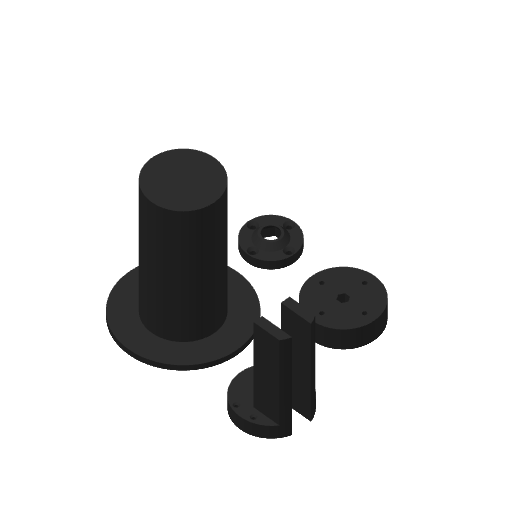
instructable/project/prints/previews/plate_5.png
