CrackpotGumption/mole_code/instructable/project/prints/previews/plate_6.png

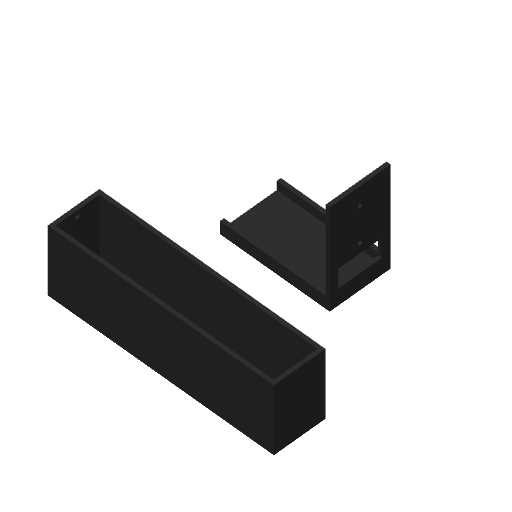
instructable/project/prints/previews/plate_6.png
