CrackpotGumption/mole_code/instructable/project/drawings/generate_wiring.js

const fs=require('fs'),path=require('path');
const sharp=require('/Users/scalarmac/.cache/codex-runtimes/codex-primary-runtime/dependencies/node/node_modules/sharp');
const esc=s=>String(s).replaceAll('&','&amp;').replaceAll('<','&lt;');
const t=(x,y,s,z=22,c='#263744',a='start')=>`<text x="${x}" y="${y}" font-size="${z}" fill="${c}" text-anchor="${a}">${esc(s)}</text>`;
const box=(x,y,w,h,title,lines,fill='#edf4f8')=>`<rect x="${x}" y="${y}" width="${w}" height="${h}" rx="8" fill="${fill}" stroke="#577283" stroke-width="2"/>`+t(x+20,y+35,title,25)+lines.map((s,i)=>t(x+20,y+72+i*30,s,20)).join('');
const wire=(pts,c='#4d798f',dash=false)=>`<polyline points="${pts}" fill="none" stroke="${c}" stroke-width="4" ${dash?'stroke-dasharray="9 6"':''} marker-end="url(#arrow)"/>`;
const start=(title,sub)=>`<svg xmlns="http://www.w3.org/2000/svg" width="1600" height="1300" viewBox="0 0 1600 1300"><defs><marker id="arrow" viewBox="0 0 10 10" refX="9" refY="5" markerWidth="6" markerHeight="6" orient="auto"><path d="M0 0L10 5L0 10Z" fill="context-stroke"/></marker></defs><style>text{font-family:Arial,sans-serif}</style><rect width="1600" height="1300" fill="white"/>${t(55,60,title,34)}${t(55,102,sub,20)}${t(55,1265,'REVIEW • wiring relationships, not physical connector orientation • © 2026 crackpotgumption • CC BY 4.0',17,'#687985')}`;
let p=start('04 — DC power and controller connections','Three separate sources: computer USB for Mega, 5 V supply for collars, 12 V supply for valve coils.');
p+=box(60,160,390,150,'Host computer',['Runs Python; USB serial to Mega','USB speakers or other audio out']);
p+=box(610,160,400,150,'Arduino Mega',['USB-powered from host only','5 V logic; GND joins common DC ground']);
p+=wire('450,230 610,230','#4d798f')+t(490,210,'USB',20);
p+=box(1160,160,370,150,'Driver logic / mux',['Both supplied by dedicated 5 V rail','Common ground with Mega']);
p+=wire('1080,470 1080,235 1160,235','#b66a18')+t(1095,330,'+5 V',18);
p+=box(60,390,390,160,'5 V, 10 A supply',['+5 V → master 5 V block','0 V → master ground block'],'#fff2df');
p+=box(610,390,400,160,'Deck 5 V / GND buses',['18 AWG feeders from master blocks','22 AWG general wiring as used'],'#fff2df');
p+=box(1160,390,370,160,'Five NeoPixel collars',['+5 V and GND from deck buses','19 pixels each; 95 total'],'#fff2df');
p+=wire('450,470 610,470','#b66a18')+wire('1010,470 1160,470','#b66a18');
p+=box(60,640,390,160,'12 V, 5 A supply',['+12 V → master 12 V block','0 V → master ground block'],'#fce9e6');
p+=box(610,640,400,160,'Adafruit #6318 driver',['Coil-power V+ ← +12 V','Power GND ← common DC ground'],'#fce9e6');
p+=box(1160,640,370,160,'Five valve coils',['Each coil: board + to numbered output','Outputs 0–4 match target IDs'],'#fce9e6');
p+=wire('450,720 610,720','#b24d3e')+wire('1010,720 1160,720','#b24d3e');
p+=box(60,890,1470,140,'Common DC ground',['Join Mega GND, driver GND, mux/sensor grounds, LED grounds, and both supply 0 V returns.','Keep +5 V and +12 V positive rails separate. External collar supply does not feed Mega 5 V.'],'#e9edf0');
p+=t(60,1090,'Driver Vcc is logic power; driver V+ is coil power. They are different terminals.',23);
p+=t(60,1130,'MPU6050 breakout VCC inputs also use the dedicated 5 V rail.',21,'#8b4c22');
p+=t(60,1170,'Compressor uses its separate AC connection. This drawing covers DC wiring, not mains installation.',20);
p+='</svg>';

let s=start('05 — Signals, channel mapping and one target','Target numbers stay identical across driver outputs, mux channels and independent LED-data runs.');
s+=box(60,165,430,185,'Arduino Mega',['D20 / SDA → driver SDA and mux SDA','D21 / SCL → driver SCL and mux SCL','D24 → normally-open Start → GND','D24 configured INPUT_PULLUP']);
s+=box(650,165,400,185,'Adafruit #6318',['I²C address 0x20; logic Vcc = 5 V','Numbered outputs 0–4 → coil returns','Board + terminals → coil positives','GPIO B pins are not the coil outputs']);
s+=wire('490,220 650,220')+t(535,200,'I²C',20);
s+=box(650,395,400,165,'TCA9548A mux',['I²C address 0x70','SD0/SC0 … SD4/SC4 → sensors','Channels 5–7 unused']);
s+=wire('490,285 550,285 550,450 650,450')+t(565,420,'I²C',20);
s+=box(1160,395,370,165,'Five MPU6050 boards',['One sensor on each mux channel','Each at 0x68; AD0 low','Mount each with Y axis vertical']);
s+=wire('1050,470 1160,470')+t(1075,450,'SDA/SCL',17);
s+=box(60,395,430,165,'LED data is independent',['D14 … D18 → collars 0 … 4 DIN','Each collar has 19 pixels','5 V / GND from deck buses (sheet 04)']);
s+=t(60,640,'TARGET CONNECTION TABLE',25);
const widths=[200,270,290,300,410],xs=[60,260,530,820,1120];
const headers=['Target','Mega → collar DIN','Mux → sensor','Driver → coil return','Physical position'];
const rows=[['0','D14','SD0 / SC0','0 (A0 on rear)','Front left'],['1','D15','SD1 / SC1','1 (A1 on rear)','Front center'],['2','D16','SD2 / SC2','2 (A2 on rear)','Front right'],['3','D17','SD3 / SC3','3 (A3 on rear)','Rear left'],['4','D18','SD4 / SC4','4 (A4 on rear)','Rear right']];
for(let r=0;r<6;r++)for(let col=0;col<5;col++){let y=670+r*53;s+=`<rect x="${xs[col]}" y="${y}" width="${widths[col]}" height="53" fill="${r===0?'#d9e8f0':r%2?'#f4f7f9':'white'}" stroke="#c5d1d9"/>`+t(xs[col]+12,y+33,r===0?headers[col]:rows[r-1][col],r===0?19:21);}
s+=t(60,1050,'SENSOR INTERFACE — review boundary',23,'#8b4c22');
s+=t(60,1088,'Driver, mux and MPU6050 breakout power all comes from the dedicated 5 V rail.',20,'#8b4c22');
s+=t(60,1124,'Do not infer 5 V sensor tolerance from the Mega or from a different vendor’s breakout. Grounds are common.',20,'#8b4c22');
s+=t(60,1170,'NeoPixel series data resistors / supply capacitor are guidance additions; not shown as confirmed installed parts.',19);
s+='</svg>';
(async()=>{for(const [name,svg] of [['04_dc_power',p],['05_signal_mapping',s]]){fs.writeFileSync(path.join(__dirname,name+'.svg'),svg);await sharp(Buffer.from(svg)).png().toFile(path.join(__dirname,name+'.png'));}console.log('Created two wiring review sheets.');})();
