CrackpotGumption/mole_code/(commit log)

2026-09-14 Including fix for module based run
    [mole_game.py]
2026-09-14 fixing game solver, game logic, bug definitions, moving to ack basis for serial rx
    [app.py, bugs.py, game.py, hardware.py, mole_game.py]
2026-09-14 fixing the serial communication
    [app.py]
2026-09-15 Updating python code and arduino code for functional test 1
2026-09-20 Adding new arduino to remove the hit processing on the arduino side, sending everything to serial
2026-10-02 adding fail state, power recovery, and audio cues
    [app.py, audio_cues.py, mole_game.py]
2026-10-09 correnting a service access error
    [diagnostics.py, firmware.py, hardware.py]
2026-10-09 removing some stuff that does not work
    [audio_cues.py, cabinet.py, diagnostics.py]
2026-10-10 Updating items and removing some failing noises
    [MOLE_FINAL_NO_INTERVAL_v2.ino, cabinet.py, diagnostics.py, mole_game.py]
