CrackpotGumption/mole_code/(notices)

Notices in the files:
instructable/project/drawings/generate_wiring.js:
www.w3.org/2000/svg" width="1600" height="1300" viewBox="0 0 1600 1300">text{font-family:Arial,sans-serif}${t(55,60,title,34)}${t(55,102,sub,20)}${t(55,1265,'REVIEW • wiring relationships, not physical connector orientation • © 2026 crackpotgumption • CC BY 4.0',17,'#687985')}`;
